ehughes/rioux_chem_control/Chem Box RJ45 Pinouts.xlsx

MFC Channels |  | 4-20ma Pressure Sensor Channels |  | Misc Digital Output Channels
RJ45 Pin | Description | RJ45 Pin | Description | RJ45 Pin | Description
1 | MFC +15v Supply (Relay Controlled) | 1 | Sensor Current In Channel 0 | 1 | Digital Output Channel 0
2 | Ground | 2 | +15v Sensor Excitation | 2 | Ground
3 | MFC -15v Supply (Relay Controlled) | 3 | Sensor Current In Channel 1 | 3 | Digital Output Channel 1
4 | Ground | 4 | +15v Sensor Excitation | 4 | Ground
5 | Ground | 5 | Not Connected | 5 | Digital Output Channel 2
6 | MFC Analog Output | 6 | Not Connected | 6 | Ground
7 | Ground | 7 | Not Connected | 7 | Digital Output Channel 3
8 | MFC Analog Input | 8 | Not Connected | 8 | Ground
Misc Analog out Channels |  | Misc Analog Input channels |  | RS232 Channels
RJ45 Pin | Description | RJ45 Pin | Description | RJ45 Pin | Description
1 | Analog Output Channel 3 | 1 | Analog Input Channel 3 | 1 | Ground
2 | Ground | 2 | Ground | 2 | TX Channel 0
3 | Analog Output Channel 2 | 3 | Analog Input Channel 2 | 3 | Ground
4 | Ground | 4 | Ground | 4 | RX Channel 0
5 | Analog Output Channel 1 | 5 | Analog Input Channel 1 | 5 | Ground
6 | Ground | 6 | Ground | 6 | TX Channel 1
7 | Analog Output Channel 0 | 7 | Analog Input Channel 0 | 7 | Ground
8 | Ground | 8 | Ground | 8 | TX Channel 1
