ehughes/rioux_chem_control/Raw Design Files/SCH/REV B/CHEM_CONTROL_BOX.PcbDoc.htm

Reporting Options

# File in Previous Format

Date | : | 7/24/2014
Time | : | 8:39:36 AM
Filename | : | C:\Users\emh203\Dropbox\Rioux Chem Control Box\Raw Design Files\SCH\REV B\CHEM_CONTROL_BOX.PcbDoc

Version | Warning
Release 14 | CAUTION - The Differential Pairs Routing rule added support for control of the width. Be aware that Width rules pertaining to differential pairs need to be manually moved to the Differential Pairs Routing rule.

This file was generated by an earlier version of the software
