ehughes/rioux_chem_control/Raw Design Files/SCH/REV A/CHEM_CONTROL_BOX.PcbDoc.htm

Reporting Options

# File in Previous Format

Date | : | 8/31/2015
Time | : | 6:41:57 PM
Filename | : | Z:\Dropbox\Rioux Chem Control Box\Raw Design Files\SCH\REV A\CHEM_CONTROL_BOX.PcbDoc

Version | Warning

This file was generated by an earlier version of the software
