ehughes/rioux_chem_control/ORDER - BUILD - PRODUCTION DATA/PCB/BOM---CHEM_BOX_a_.xls

Sheet: Part List Report
 | Assembly Sheet |  |  | CHEM_BOX
 |  |  | Variant: | None
 |  |  | Rev: | a
 | Report Date: |  | 1/5/2014 | 3:39:50 PM
 | Print Date: |  | 2014-01-05 | 15:40:05
# | Quantity | Designator | Description | Manufacturer | Manufacturer Part Number | Supplier 1 | Supplier Part Number 1
1 | 71 | C1, C2, C3, C4, C5, C6, C7, C8, C9, C10, C11, C12, C13, C14, C15, C16, C17, C18, C19, C20, C21, C22, C23, C24, C33, C34, C35, C36, C37, C38, C39, C40, C41, C42, C43, C44, C45, C46, C47, C48, C49, C50, C51, C52, C53, C54, C55, C56, C57, C58, C59, C60, C61, C62, C63, C64, C65, C66, C68, C69, C70, C71, C72, C73, C74, C75, C76, C77, C79, C81, C85 | CAP CER 0.1UF 50V 10% X7R 0805 | Murata Electronics North America | GRM21BR71H104KA01L | Digi-Key | 490-1666-1-ND
2 | 8 | C25, C26, C27, C28, C29, C30, C31, C32 | CAP CER 0.1UF 250V 10% X7R 1206 | Murata Electronics North America | GRM31CR72E104KW03L | Digi-Key | 490-3542-1-ND
3 | 4 | C67, C78, C82, C83 | CAP ALUM 47UF 25V 20% SMD | Panasonic Electronic Components | EEE-FK1E470P | Digi-Key | PCE3804CT-ND
4 | 1 | C80 | CAP ALUM 330UF 25V 20% SMD | Panasonic Electronic Components | EEE-FK1E331P | Digi-Key | PCE3803CT-ND
5 | 2 | D1, D2 | DIODE SCHOTTKY 100V 1A SMA | Diodes Inc | B1100-13-F | Digi-Key | B1100-FDICT-ND
6 | 1 | F1 | FUSE 16A 250VAC 5X20 SLOW | Littelfuse Inc | 0215016.MXP | Digi-Key | F6044-ND
7 | 1 | J1 | AC Power Entry Modules SNAP-N PCB 2-POLE | Schurter | KP01.1112.11 | Mouser | 693-KP01.1112.11
8 | 40 | J2, J3, J4, J5, J6, J7, J8, J9, J10, J11, J12, J13, J14, J15, J16, J17, J18, J19, J20, J21, J22, J23, J24, J25, J26, J27, J28, J29, J30, J31, J32, J33, J34, J35, J36, J37, J38, J39, J40, J41 | TERM W/ASSEMBLD SCREW VERT PCMNT | Keystone Electronics | 7701 | Digi-Key | 7701K-ND
9 | 12 | J42, J43, J44, J45, J46, J47, J48, J49, J50, J51, J52, J53 | Vertical K type thermocouple connector - K | Omega |  | Omega | PCC-SMP-K-100
10 | 1 | J54 | CONN MOD JACK R/A 8P8C SHIELDED | TE Connectivity | 5569263-1 | Digi-Key | A31480-ND
11 | 2 | J55, J56 | CONN TERM BLOCK T/H 2POS 3.5MM | Phoenix Contact | 1984617 | Digi-Key | 277-1721-ND
12 | 1 | J57 | CONN HEADER 8POS 2MM RT ANG TIN | Hirose Electric Co Ltd | DF11-8DP-2DS(24) | Digi-Key | H10246-ND
13 | 1 | J58 | CONN RECEPT 8POS 2MM PCB TIN | Hirose Electric Co Ltd | DF11-8DS-2DSA(05) | Digi-Key | H10170-ND
14 | 2 | J59, J60 | SAMTEC - SSM-120-S-SV-LC - .025 SOCKET STRIPS | SAMTEC | SSM-120-S-SV-LC | Newark | 81P6611
15 | 1 | J61 | 1734035-2 | TE Connectivity | 1734035-2 | Digi-Key | A31727CT-ND
16 | 1 | L1 | 100 uH 0.31A | Coilcraft | DO1608C-104_L | Coilcraft | DO1608C-104_L
17 | 3 | Q1, Q2, Q3 | MOSFET N-CH 60V 4A SOT-223-4 | Fairchild Semiconductor | NDT3055L | Digi-Key | NDT3055LCT-ND
18 | 20 | R1, R2, R3, R4, R5, R6, R7, R8, R9, R10, R11, R12, R13, R14, R15, R16, R17, R18, R19, R20 | RES 91 OHM 1/8W 1% 0805 SMD | Panasonic Electronic Components | ERJ-6ENF91R0V | Digi-Key | P91.0CCT-ND
19 | 8 | R21, R22, R23, R24, R25, R26, R27, R28 | RES 47 OHM 1/4W 1% 1206 SMD | Panasonic Electronic Components | ERJ-8ENF47R0V | Digi-Key | P47.0FCT-ND
20 | 28 | R29, R30, R31, R32, R33, R34, R36, R37, R38, R39, R40, R41, R42, R43, R44, R45, R46, R48, R49, R51, R52, R53, R54, R55, R56, R57, R58, R63 | RES 100K OHM 1/8W 1% 0805 SMD | Panasonic Electronic Components | ERJ-6ENF1003V | Digi-Key | P100KCCT-ND
21 | 1 | R35 | RES 1K OHM 1/8W 1% 0805 SMD | Panasonic Electronic Components | ERJ-6ENF1001V | Digi-Key | P1.00KCCT-ND
22 | 2 | R47, R50 | RES 240 OHM 1/8W 1% 0805 SMD | Panasonic Electronic Components | ERJ-6ENF2400V | Digi-Key | P240CCT-ND
23 | 4 | R59, R60, R61, R62 | RES 10K OHM 1/8W 1% 0805 SMD | Panasonic Electronic Components | ERJ-6ENF1002V | Digi-Key | P10.0KCCT-ND
24 | 1 | U1 | FUSEHOLDER FPG5 5X20 IP 40 | Schurter Inc | 3101.0055 | Digi-Key | 486-2056-ND
25 | 8 | U2, U3, U4, U5, U6, U7, U8, U9 | Solid State Relays - PCB Mount 16A Zero Cross Type Triac output SSR | Sharp Microelectronics | S116S02F | Mouser | 852-S116S02F
26 | 1 | U10 | DEVELOPMENT BOARD LPC1768 MBED | NXP Semiconductors | OM11043 | Digi-Key | 568-4916-ND
27 | 12 | U11, U12, U13, U14, U15, U16, U17, U19, U20, U22, U23, U24 | IC CONV THERMOCOUPLE-DGTL 8SOIC | Maxim Integrated | MAX31855KASA+T | Digi-Key | MAX31855KASA+TCT-ND
28 | 2 | U18, U21 | IC DECODER/DEMUX 3-8 LINE 16SO | Texas Instruments | SN74HC138NSR | Digi-Key | 296-12886-1-ND
29 | 12 | U25, U26, U27, U28, U29, U30, U31, U32, U33, U34, U35, U36 | RELAY SSR 10MA 240V 1.2A 8-DIP | Sharp Microelectronics | PR3BMF51NSKF | Digi-Key | 425-2562-5-ND
30 | 4 | U37, U39, U53, U65 | IC SHIFT REGISTER 8BIT 16-SOIC | Texas Instruments | SN74AHC594DR | Digi-Key | 296-31743-1-ND
31 | 5 | U38, U40, U41, U42, U67 | IC BUFF/DVR TRI-ST 8BIT 20SOIC | Texas Instruments | SN74LVTH541DW | Digi-Key | 296-8728-5-ND
32 | 1 | U43 | 64x32 Compact Smart Switch | NKK Switches | IS15DSBFP4RGB | Mouser | 633-IS15DSBFP4RGB
33 | 1 | U44 | CONV AC/DC 25W 15V 1.6A PCB | CUI Inc | VSK-S25-15U | Digi-Key | 102-2413-ND
34 | 1 | U45 | CONV AC/DC 5W 15V 0.33A PCB | CUI Inc | VSK-S5-15UA | Digi-Key | 102-2389-ND
35 | 1 | U46 | CONV AC/DC 5W 5V 1A PCB | CUI Inc | VSK-S5-5UA | Digi-Key | 102-2386-ND
36 | 2 | U47, U48 | FAN 40X10MM 5VDC 1.08W 8CFM | Sunon Fans | ME40100V1-000U-A99 | Digi-Key | 259-1575-ND
37 | 1 | U49 | RELAY GENERAL PURPOSE DPST 5A 5V | Omron Electronics Inc-EMC Div | G6B-2214P-US DC5 | Digi-Key | Z947-ND
38 | 2 | U50, U51 | IC ADC 12BIT 2.7V 8CH SPI 16SOIC | Microchip Technology | MCP3208-BI/SL | Digi-Key | MCP3208-BI/SL-ND
39 | 2 | U52, U58 | IC 8 CHANNEL DAC S/O 20-SOIC | Texas Instruments | TLV5608IDW | Digi-Key | 296-3036-5-ND
40 | 8 | U54, U55, U56, U57, U60, U61, U62, U63 | IC OPAMP 1.8V 1MHZ DUAL 8-SOIC | Microchip Technology | MCP6002-I/SN | Digi-Key | MCP6002-I/SN-ND
41 | 1 | U59 | CT-1205 | CUI Inc | CT-1205 | Digi-Key | 102-1199-6-ND
42 | 1 | U64 | IC XLATR 2BIT BI-DIREC 8SOIC | NXP Semiconductors | GTL2002D,112 | Digi-Key | 568-4224-5-ND
43 | 1 | U66 | IC RS232 3V5.5V DRVR ESD 20-SOIC | Texas Instruments | MAX3223ECDWR | Digi-Key | 296-19839-1-ND
44 | 1 | U68 | IC REG LDO 3.3V 950MA SOT-223 | STMicroelectronics | LD1117S33CTR | Digi-Key | 497-1241-1-ND
Approved |  |  |  | Notes

Sheet: Project Information
Project Full Path | C:\Users\ehughes\Dropbox\Rioux Chem Control Box\RAW DESIGN FILES\SCH\REV A\CHEM_CONTROL_BOX.PrjPcb
Project Filename | CHEM_CONTROL_BOX.PrjPcb
Variant Name | None
Data-Source Filename | CHEM_CONTROL_BOX.PrjPcb
Data-Source Full Path | C:\Users\ehughes\Dropbox\Rioux Chem Control Box\RAW DESIGN FILES\SCH\REV A\CHEM_CONTROL_BOX.PrjPcb
Title | <Parameter Title not found>
Total Quantity | 283
Report Time | 3:39:50 PM
Report Date | 1/5/2014
Report Date & Tine | 1/5/2014 3:39:50 PM
Output Name | Assembly BOM
Output Type | BOM_PartType
Output Generator Name | BOM
Output Generator Description | Bill of Materials
