ehughes/rioux_chem_control/riouxcontrolboard-rev3.xlsx

 | Summary of Required IOs
 | Quantity | Type | Notes | ADC Chip : MCP3204
 | #REF! | Digital outputs
 | 21 | Analog inputs | 7 capable of 0-5 V, 2 capable of 4-20 mA, 12 capable of thermocouples
 | 11 | Analog outputs | 0-5 V
 | 1 | RS232 communication | For control of syringe pumps and miscellaneous others
I/O
Description | Channels Count | Type | Connector | Desc | Eli Question / Comment | Nick Reponse
Solenoid Valves | 12 | Digital output | Phoenix 1762703 + 2x Phoenix 1777387 | Each output coupled to a relay capable of handling 120 V (current for each relay will be less than 0.1 A) | Just to be clear, do you want a dry contact output that can handle switching 120VAC at .1A? OR do you want some output signal (for example +15v that can drive a relay coil). | This would be the power that actuates solenoids we already have (spec'd at 120V, future ones COULD be bought at different specs). Let us know what's reasonable - This would involve hooking up 120 V to the board but only for this one use (we don't know if that's reasonable or the most convenient method)
MFC Power Control | 1 | Digital output | N/A | Attach to a DPST relay to turn off the +/- 15V power to the MFCs | It sounds like this is "internal". Will there ever be a need to control power to each MFC individually? | So far we've designed these systems so that all MFCs are powered on/off together. This should be fine for future designs too.
MFC | 7 | Analog input (0-5 V) | Part of RJ45 - 5569263-1 (12 Channel RJ25) |  | By "Ethernet" I assume you mean "a CAT 5" Jack. We may want to consider a shield cable like CAT-6 | We don't need a very quick update rate. Previously I've sampled at about 1 Hz, but to allow for some averaging or faster systems I'd say 10 Hz should work.
 |  | Analog output (0-5 V) |  |  | What Sampling/update rate to you need on the Analog I/O?
 |  | +15 V |  | From external power supply - 25 mA max each
 |  | -15 V |  | From external power supply - 180 mA max each
 |  | GND
Syringe Pumps | 1 | Serial Comm | Part of RJ45 - 5569263-1 (12 Channel RJ25) |  | DB-9 is "standard" but bulky…. There are specs for RS-232 over CAT-5 | Doing everything we can with an RJ45 connector and CAT5/CAT6 cabling sounds fine to me
Misc Digital Outputs* | 4 | Digital output | Part of RJ45 - 5569263-1 (12 Channel RJ25) |  | Maybe use CAT 5 for this…. Maybe at +15v output that can source a little current?
Misc Analog Out* | 4 | Analog output (0-5 V) | Part of RJ45 - 5569263-1 (12 Channel RJ25) |  | Maybe use CAT 5 for this…. May need shielded cable (Cat 6)
Pressure Transducers | 2 | Analog inputs (4-20 mA) | Part of RJ45 - 5569263-1 (12 Channel RJ25) |  |  | In almost all cases we use K type thermocouples. However, for the sake of future proofing - can this type of hardware be designed with some adjustable jumpers to change thermocouple type or similar? Or is it you buy a chip that is designed for just K-type?
Thermocouples | 12 | Analog input/thermocouple | Omega PCC-SMP-V-K |  | What thermocouple type? J, K, etc? Most circuitry for thermocouples is fixed for a certain type. | In our typical labVIEW programs we call it "PWM," but it's at a very slow period ( ~1 second). So I guess that's more like on/off based on what you're saying.
Heater Control | 8 | Digital output | Pheonix 1762431 + Pheonix 1778043 | This signal would go to a solid state relay for heater control. Is it best to use the standalone ones we use already, or could use through-hole ones? | For the form factor I am considering, Let's just keep them as stand alone. We can select an "internal" connector to run the wires. For you PID Loop, do you "PWM" the signal? Or is it simply on/off? Let me know on your PID details…..
Power Input |  |  | Shurter GSP1.8101.1
 |  |  |  |  | Eli's General Comments/Additional Specs
 |  |  |  | #1 | My thought is to engineer a PCB such that all the connectors are vertical PCB mount. The PCB would them mount to a nice faceplate where all the connectors would "poke" through. This would get rid of most of the wiring. The challenege is getting all the connectors arranged so the "poke" out of the face plate in a nice way
 |  |  |  | #2 | Connectors tend to use up a bunch of real estate on a PCB as the use both sides. The design may end up being 2 boards. One that has all the "big" stuff and the a small plug in board that has the "brains" (surface mount components). Once we settle on specs, I can spend a little time on this. The good news is that my PCB tool can generate nice 3D models to give you an idea of how it will look | I've thought about this also. Let us know what you think is reasonable. If a truly "all-in-one" board is needlessly complicated, it wouldn't be unreasonable to start splitting the functions into different boxes (i.e. an MFC control box, a PID temperature control box).
 |  |  |  | #3 | Related to #2…… For low volume custom work like this, assembly tends to dominate final cost. I have a local place that does really nice work (have automated equipment for surface mount) but through hole is still manual. It looks like you have have enough skill that you could probably solder on the big connectors, etc. We should maybe think about having the fine pitch stuff done elsewhere and then you guys can do final builds. For this level of I/O there really isn't any microcontroller, etc that won't be surface mount. I can deliver a couple hand built units for testing but for larger QTYs it makes sense to work through a local vendor. I can be the go between to make billing, etc easier | We shouldn't have any problems with doing through-hole stuff ourselves.
 |  |  |  | #4 | As for software function, my though is to give you a simple command set that get/set any of the I/O over a USB interface. It would be something simple that someone could make some easy VI's
 |  |  |  | #5 | You mentioned there is a PID loop in the Labview code. It sounded like you we were going to move this to the microcontroller side of things and Labview would just be front end. If this is the case we need to match up certain thermocouples with the heater controllers for PID "Channels". I saw that there are more thermocouples than heater channels | Right, ideally we can move as many functions as reasonable over to the microcontroller. Our systems currently tend to have a few PID loops then just some miscellaneous temperature measurements just to monitor other parts of the system.
 |  |  |  | #6 | For safety, we may want to think about what features we want….. I.E. Big warnings for disconnected thermocouples, super high temperatures | If everything we outlined seems reasonable, I'll start making lists of useful feedback for each channel.
 |  |  |  | #7 | My end goal is to get the software to a state where you guys have a nice framework that you could write your own code. I.E. The project would have the basic features to talk to all the hardware and then you guys could then write your own special application code. I plan on implementing some sort of "bootloader" over USB. This would allow you guys to do firmware updates whenever you need and I wouldn't need to be in the loop. Think of this as a "big" arduino where can easily make your own applications. Not that I don't want to be invloved but I think gettign you a system that you can run with woudl be best. | Along with the above cell, I'll start working on a list of software functionality (including commands) we'd like and you can give us some feedback on that.
 |  |  |  | #8 | Additional Safety though…. Maybe one "e-stop" switch that will disable all heaters, outputs, etc if it is not engaged. This would be done via hardware could bypass all software.
 |  |  |  | #9 | I am going to assume that we will just by an AC power supply module for all internal power. They are a commodity item these days and it really doesn't make sense to integrate them on the board. I will just assume the PCB will be power from +/-15v | That's what I was thinking. We've been buying this particular power supply (2 per box for +/- 15V). Let us know if this works or if you now of better. (http://www.digikey.com/product-detail/en/VOF-45-15/102-1332-ND/949769)
