ehughes/rioux_chem_control/Raw Design Files/MECH/eli2.STEP

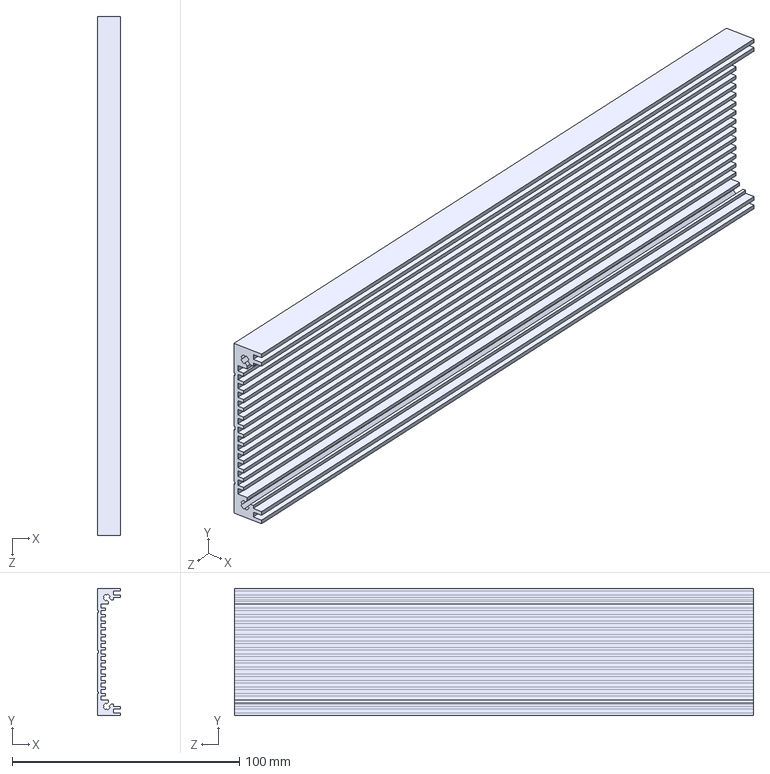
[picture p2: CAD file, 2017-01-03]
Raw Design Files/MECH/eli2.STEP
10.0 x 56.0 x 228.6 mm
