ehughes/rioux_chem_control/Raw Design Files/MECH/Box-DoubleSides.stp

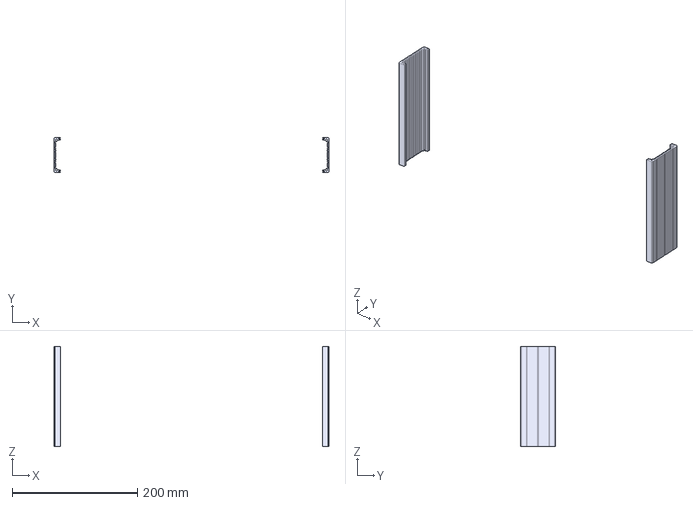
[picture p3: CAD file, 2017-01-03]
Raw Design Files/MECH/Box-DoubleSides.stp
439.6 x 56.0 x 160.0 mm
