ehughes/rioux_chem_control/Raw Design Files/MECH/eli1.STEP

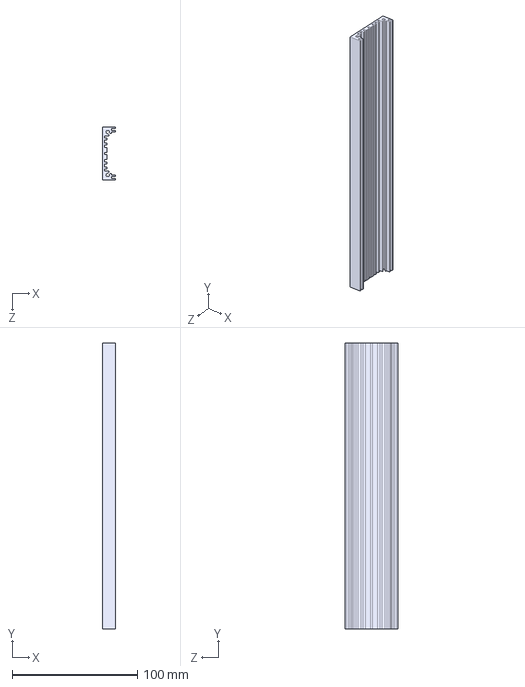
[picture p4: CAD file, 2017-01-03]
Raw Design Files/MECH/eli1.STEP
10.0 x 228.6 x 42.0 mm
