ehughes/rioux_chem_control/Raw Design Files/MECH/PROFILE2.DXF

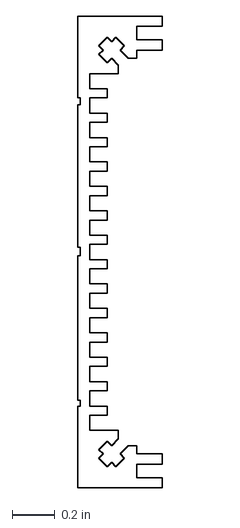
[picture p5: CAD file, 2017-01-03]
Raw Design Files/MECH/PROFILE2.DXF
0.394 x 2.20 in
