ehughes/rioux_chem_control/Raw Design Files/SCH/REV B/BUILD_PACKAGE/SCHEMATICS/SCHEMATICS---CHEM_BOX_b_.PDF

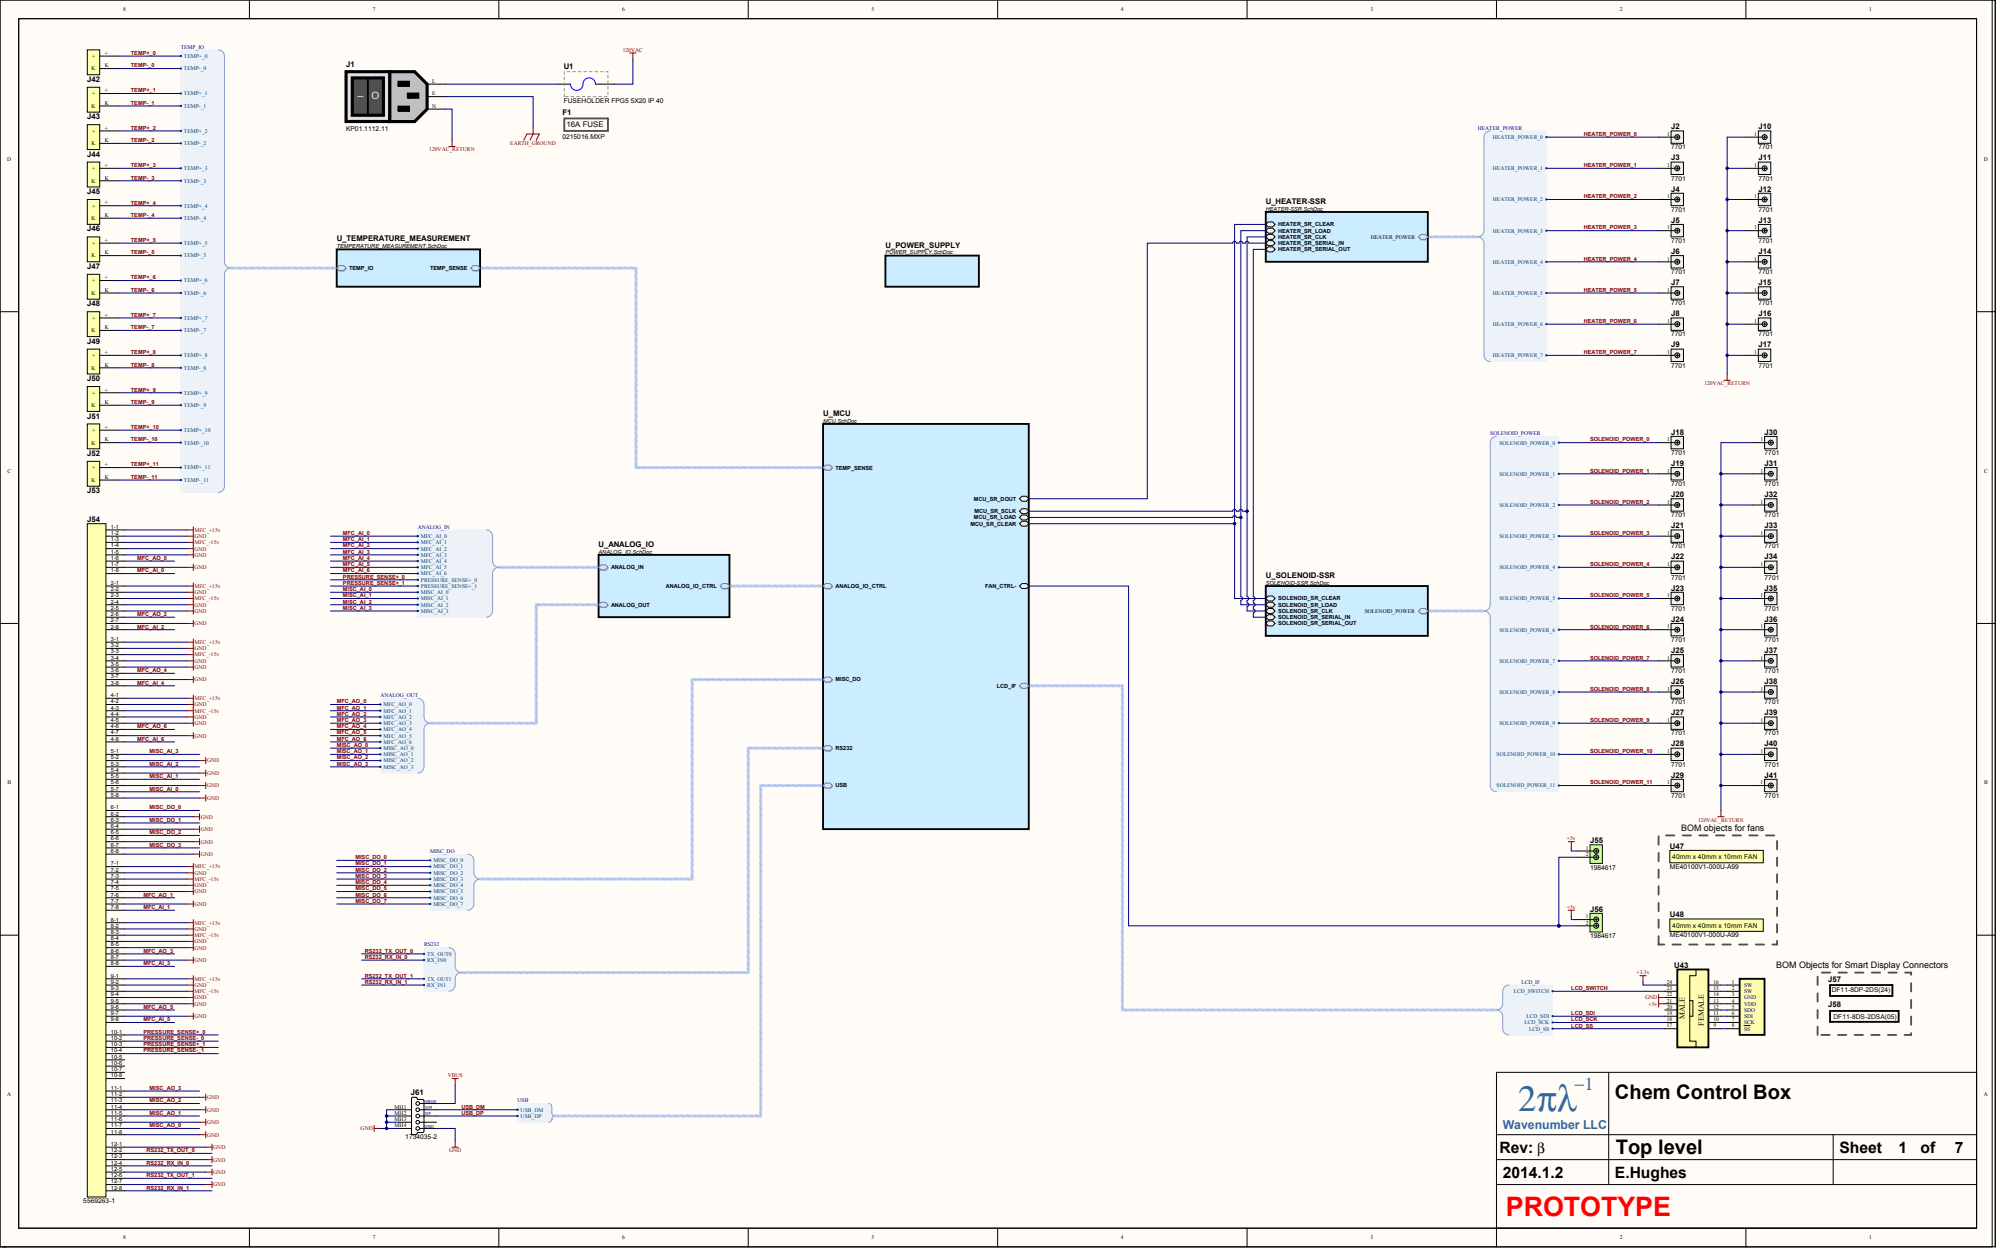
[picture p11: page 1]

120VAC_RETURN
BOM objects for fans

BOM Objects for Smart Display Connectors

2πλ−1 Wavenumber LLC | Chem Control Box

MH3
MH4

β Rev: | Top level | Sheet 1 of 7

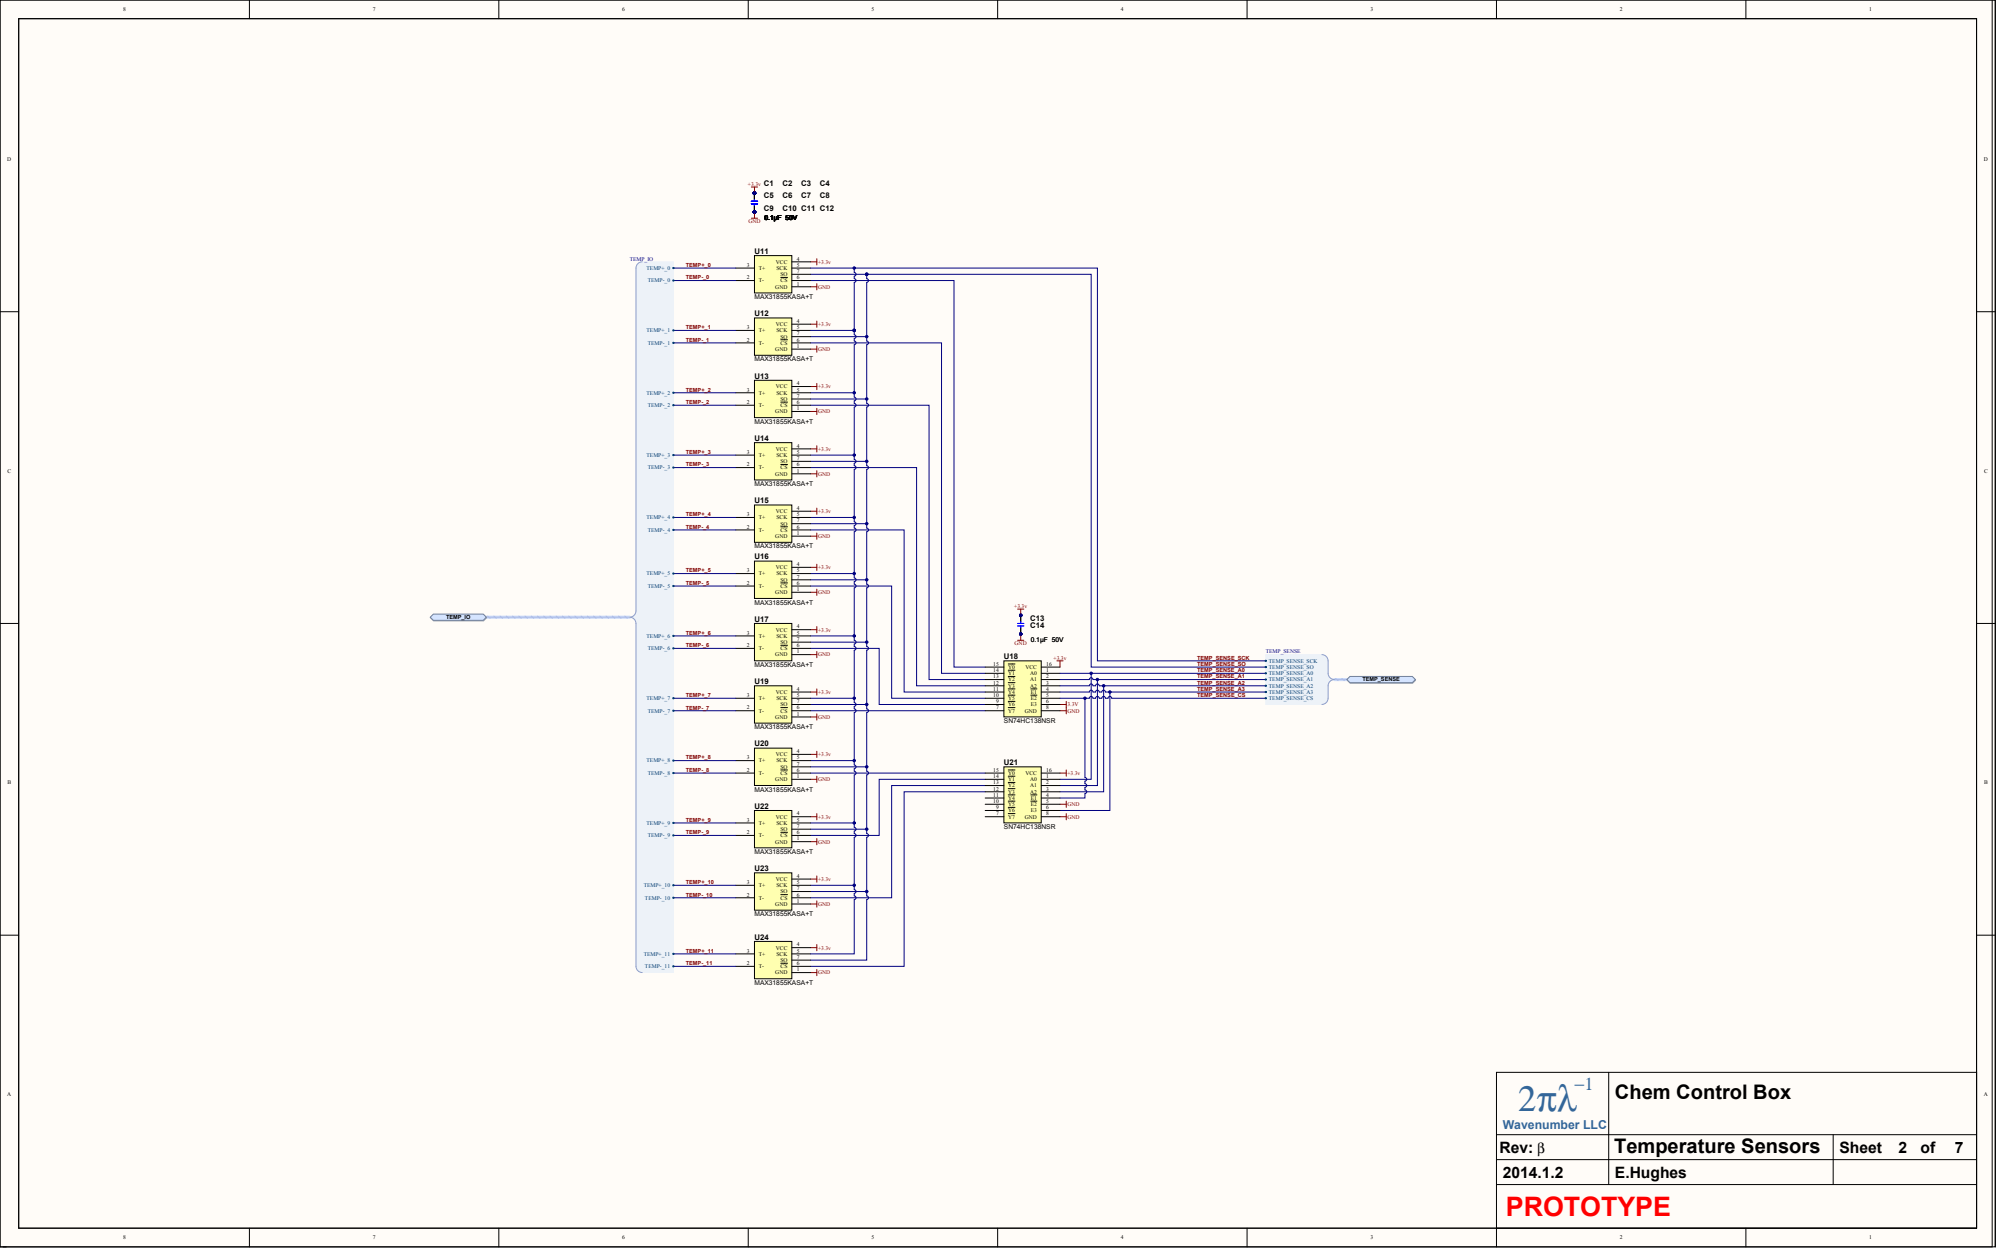
[picture p12: page 2]

VCC A0 A1 A2 E1 E2 E3 Y7 | 1 TEMP_SENSE_A 0 8 Y6

2πλ−1 Wavenumber LLC | Chem Control Box

Temperature Sensors | 2 of

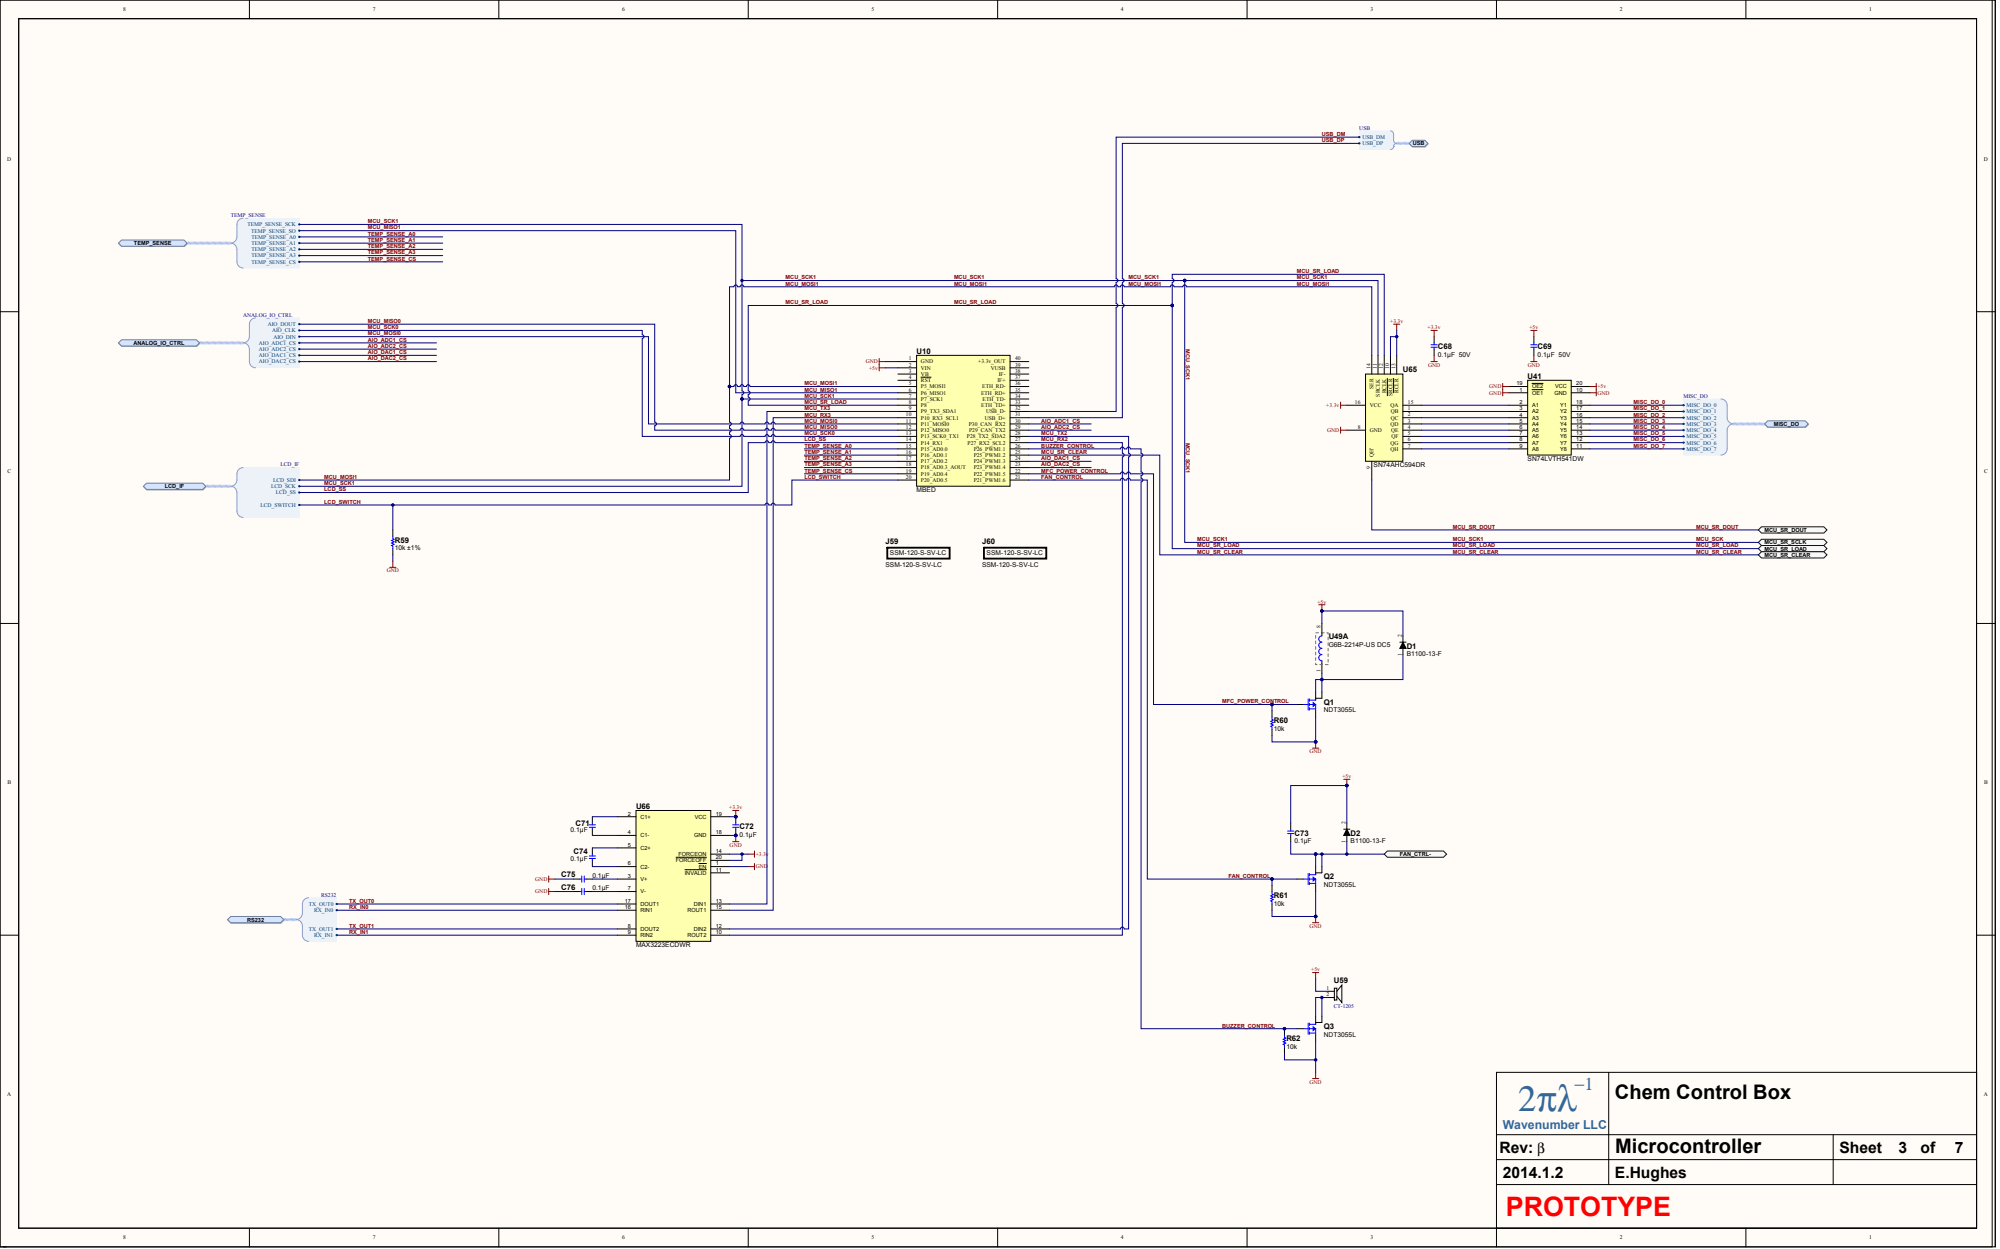
[picture p13: page 3]

MFC_POWER_CONTROL

FAN_CONTROL | R60 10k

2πλ−1 Wavenumber LLC | Chem Control Box

Microcontroller | Sheet 3 of 7

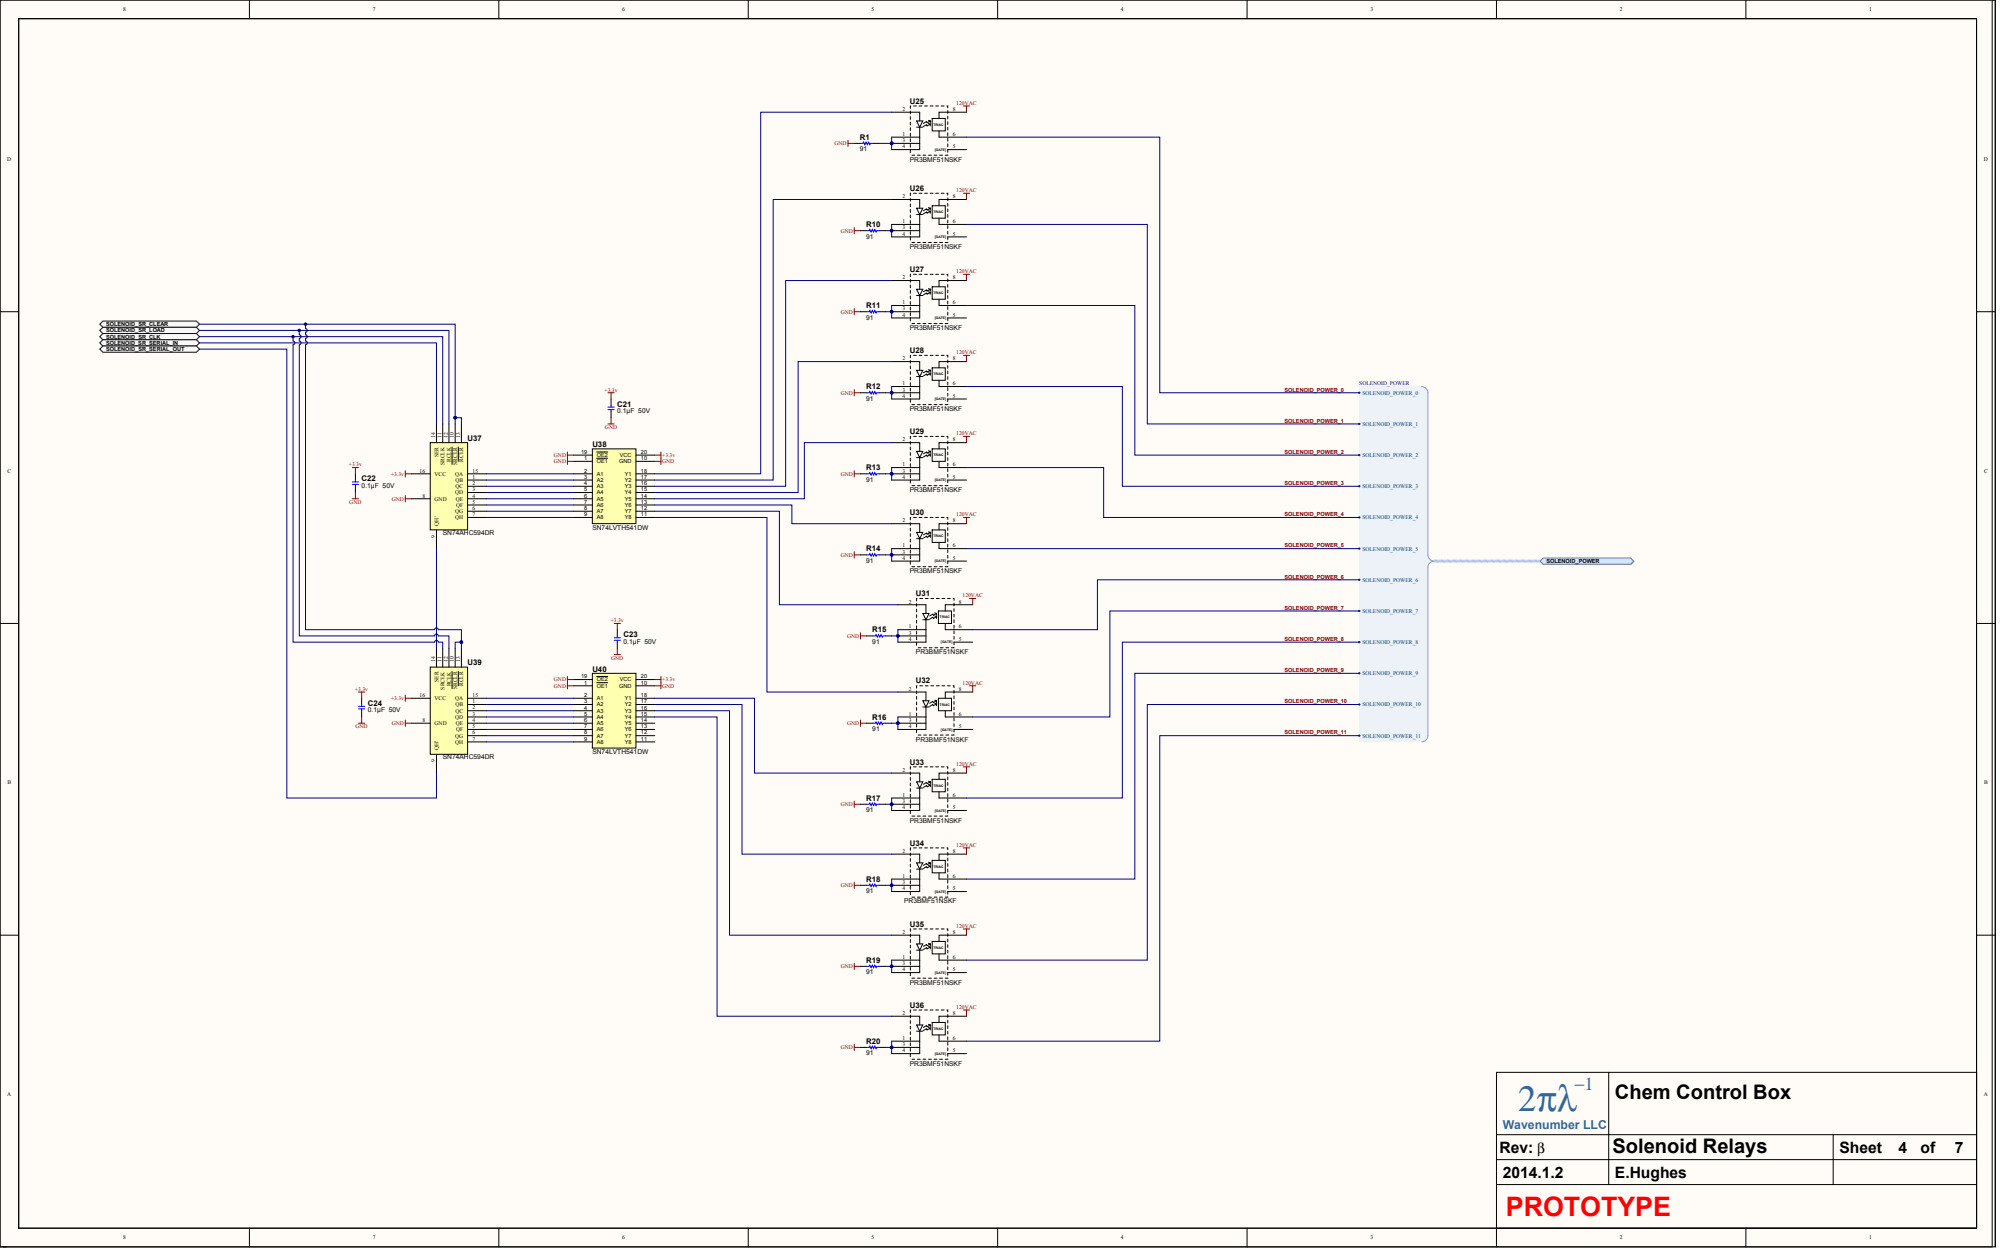
[picture p14: page 4]

2πλ−1 Wavenumber LLC | Chem Control Box

Solenoid Relays | 4 of

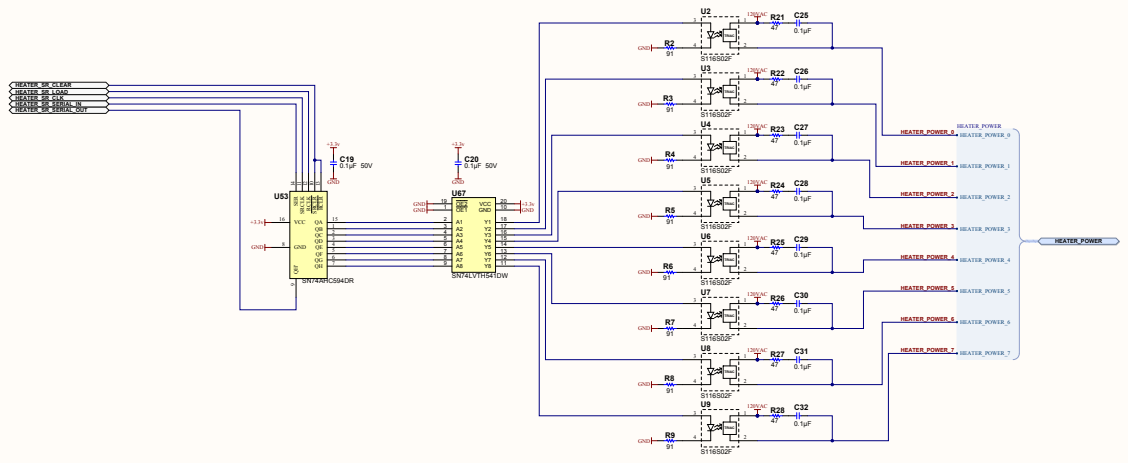
[picture p15: page 5]

2πλ−1 Wavenumber LLC | Chem Control Box

Heater Relays | 5 of

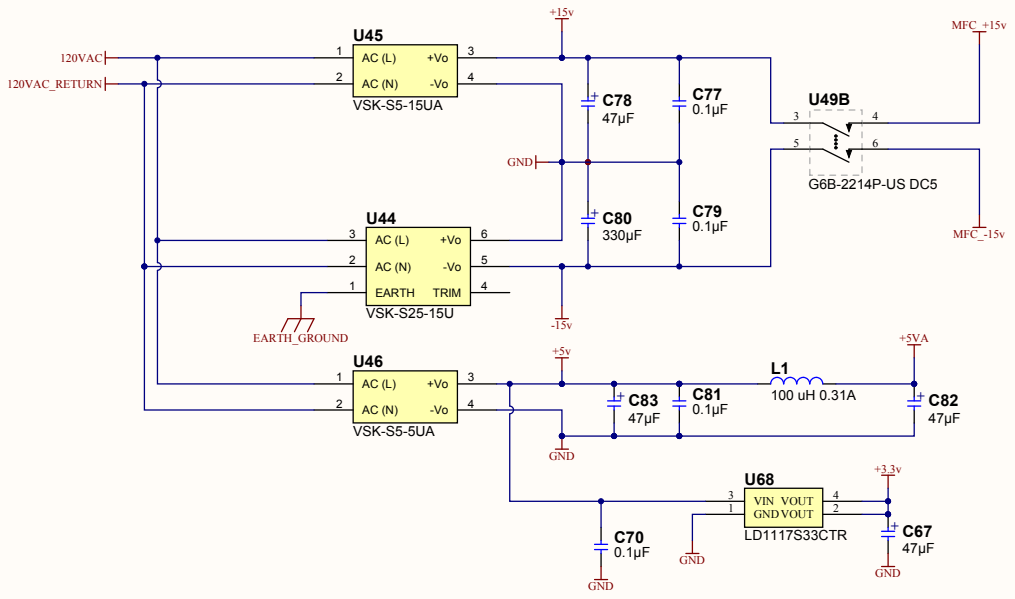
[picture p16: page 6]

EARTH 1

2πλ−1 Wavenumber LLC | Chem Control Box

Power Supply | Sheet 6 of 7

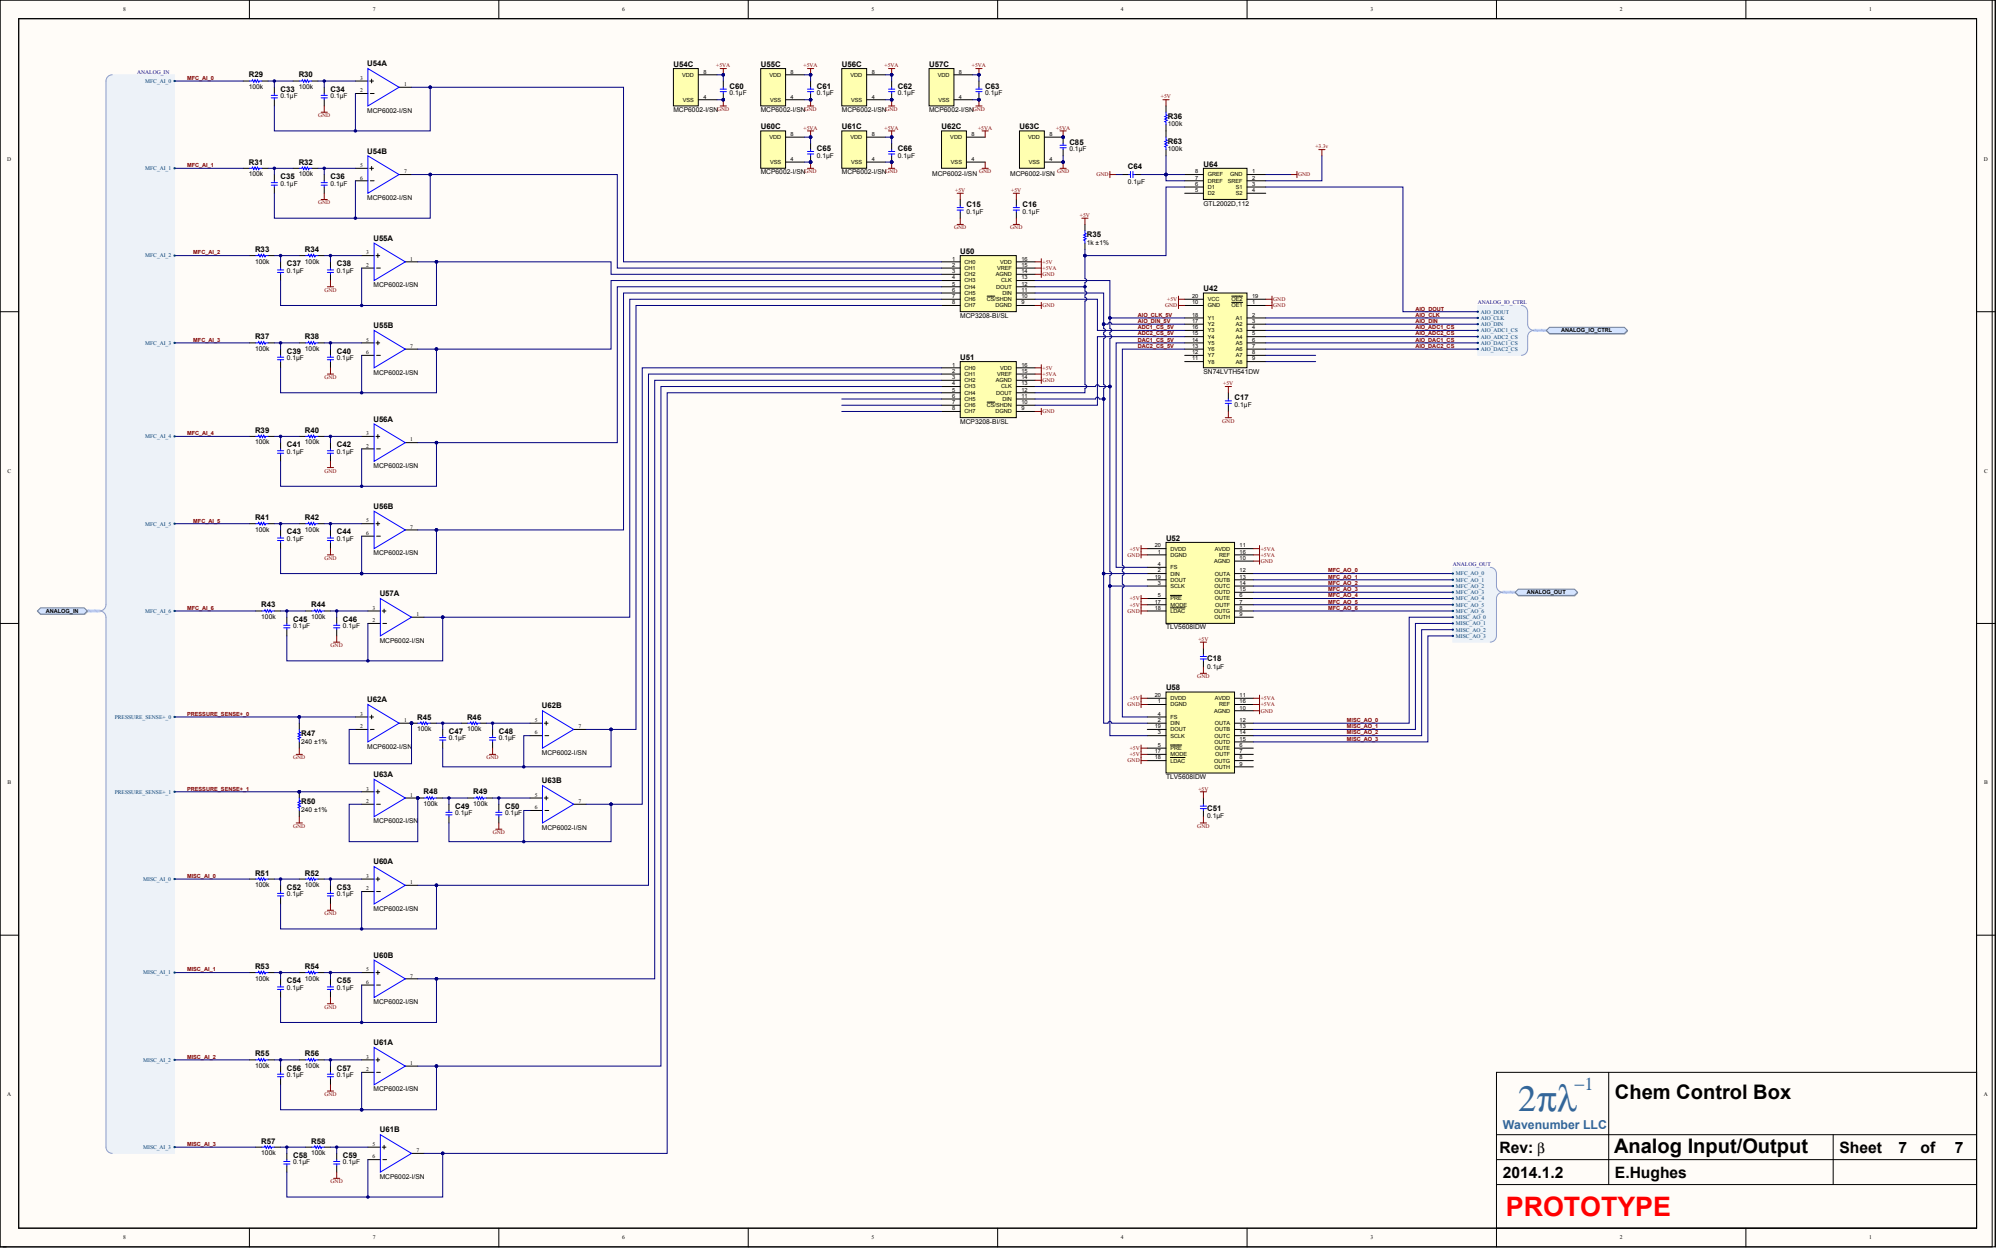
[picture p17: page 7]

CH4 5
CH5 6

AIO_CLK_5V | | GND 10
Y8 11 Y7 12 Y6 13 Y5 14 Y4 15 Y3 16 Y2 17 Y1 18 | AIO_DIN

2πλ−1 Wavenumber LLC | Chem Control Box

Analog Input/Output | Sheet 7 of 7
