ehughes/rioux_chem_control/(list of files, drawings)

Other design files:
Raw Design Files/SCH/REV A/ANALOG_IO.SchDoc
Raw Design Files/SCH/REV A/Box2.PrjPcb
Raw Design Files/SCH/REV A/CHEM_CONTROL_BOX.PrjPcb
Raw Design Files/SCH/REV A/CHEM_CONTROL_BOX.SchDoc
Raw Design Files/SCH/REV A/HEATER-SSR.SchDoc
Raw Design Files/SCH/REV A/main.SchDoc
Raw Design Files/SCH/REV A/MCU.SchDoc
Raw Design Files/SCH/REV A/PCB2.PcbDoc
Raw Design Files/SCH/REV A/PcbLib1.PcbLib
Raw Design Files/SCH/REV A/POWER_SUPPLY.SchDoc
Raw Design Files/SCH/REV A/Sheet1.SchDoc
Raw Design Files/SCH/REV A/SOLENOID-SSR.SchDoc
Raw Design Files/SCH/REV A/SSR.SchDoc
Raw Design Files/SCH/REV A/Temperature Measurement.SchDoc
Raw Design Files/SCH/REV A/TEMPERATURE_MEASUREMENT.SchDoc
Raw Design Files/SCH/REV B/ANALOG_IO.SchDoc
Raw Design Files/SCH/REV B/CHEM_CONTROL_BOX.PrjPcb
Raw Design Files/SCH/REV B/CHEM_CONTROL_BOX.SchDoc
Raw Design Files/SCH/REV B/HEATER-SSR.SchDoc
Raw Design Files/SCH/REV B/main.SchDoc
Raw Design Files/SCH/REV B/MCU.SchDoc
Raw Design Files/SCH/REV B/POWER_SUPPLY.SchDoc
Raw Design Files/SCH/REV B/SOLENOID-SSR.SchDoc
Raw Design Files/SCH/REV B/SSR.SchDoc
Raw Design Files/SCH/REV B/TEMPERATURE_MEASUREMENT.SchDoc
